codekorarjonno/18-DOF-Hexapod/raspberry_pi/ros2_ws/src/hexapod_description/meshes/README.md

# meshes

Generated by `tools/stl_to_urdf.py` from the SolidWorks STL export.
One file per link and colour, in metres, already in each link's frame.

Don't edit these by hand; re-export from SolidWorks and re-run the script.
