codekorarjonno/18-DOF-Hexapod/box.SLDPRT

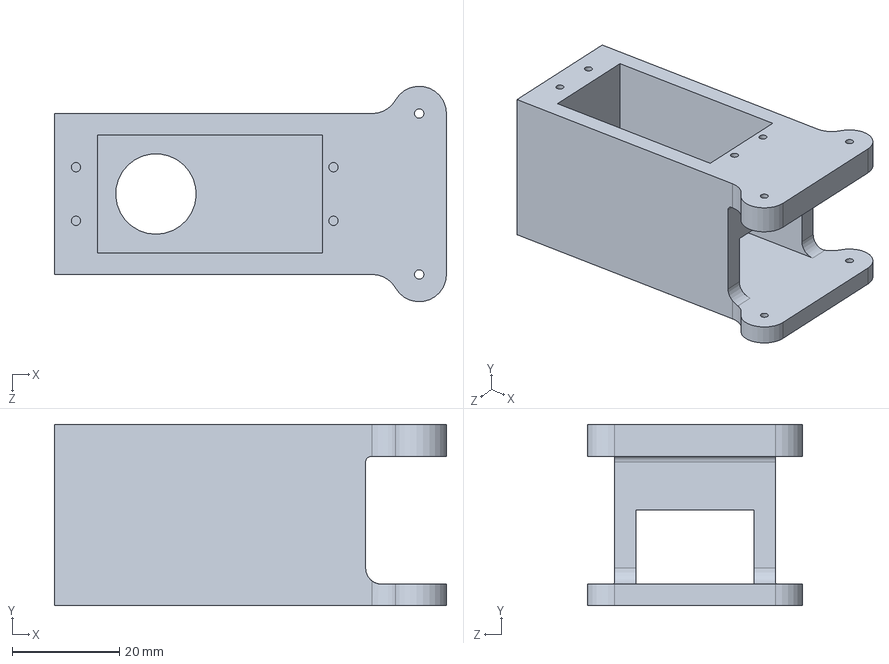
[picture p10: CAD file, 2026-10-17]
box.SLDPRT
73.1 x 33.8 x 40.1 mm
