codekorarjonno/18-DOF-Hexapod/raspberry_pi/ros2_ws/src/hexapod_description/meshes/base_frame.stl

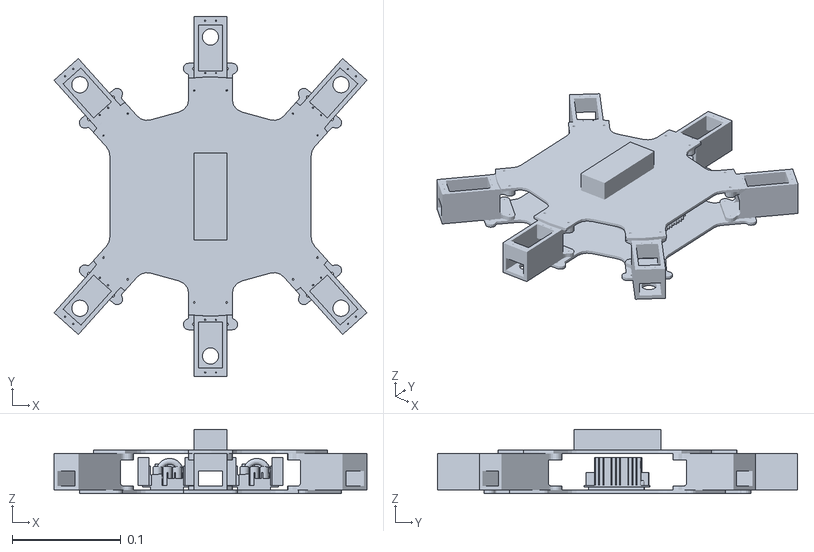
[picture p11: CAD file, 2026-11-06]
raspberry_pi/ros2_ws/src/hexapod_description/meshes/base_frame.stl
0.288 x 0.331 x 0.0588
