codekorarjonno/18-DOF-Hexapod/ros2_ws/src/hexapod_description/meshes/leg5_femur_servo.stl

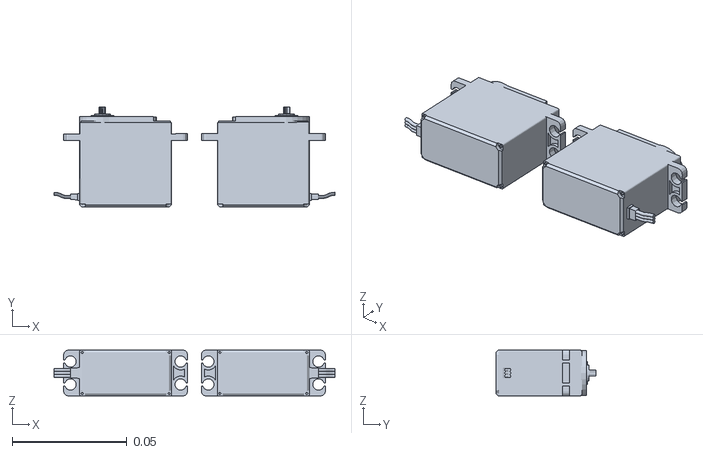
[picture p12: CAD file, 2026-11-02]
ros2_ws/src/hexapod_description/meshes/leg5_femur_servo.stl
0.122 x 0.0438 x 0.02
