codekorarjonno/18-DOF-Hexapod/solidworks/bracket.SLDPRT

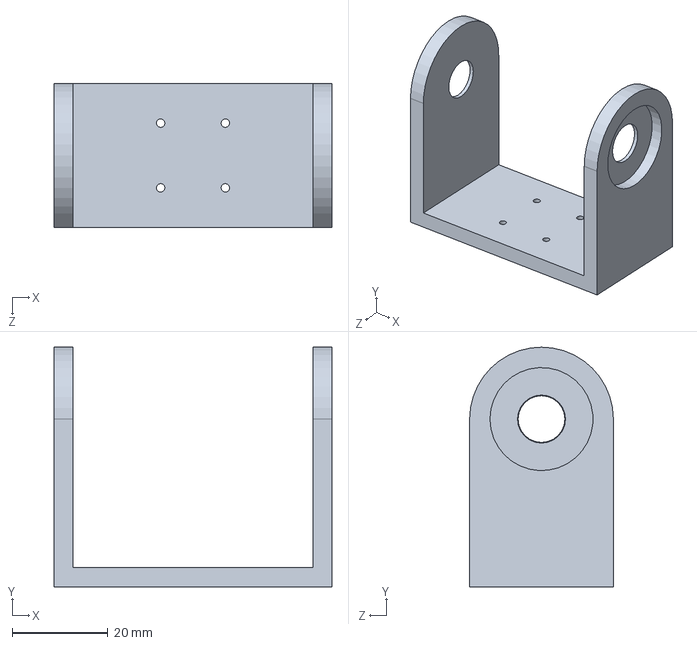
[picture p13: CAD file, 2026-11-02]
solidworks/bracket.SLDPRT
58.0 x 50.0 x 30.0 mm
