codekorarjonno/18-DOF-Hexapod/300W 20A DC-DC Buck Converter Step Down.step

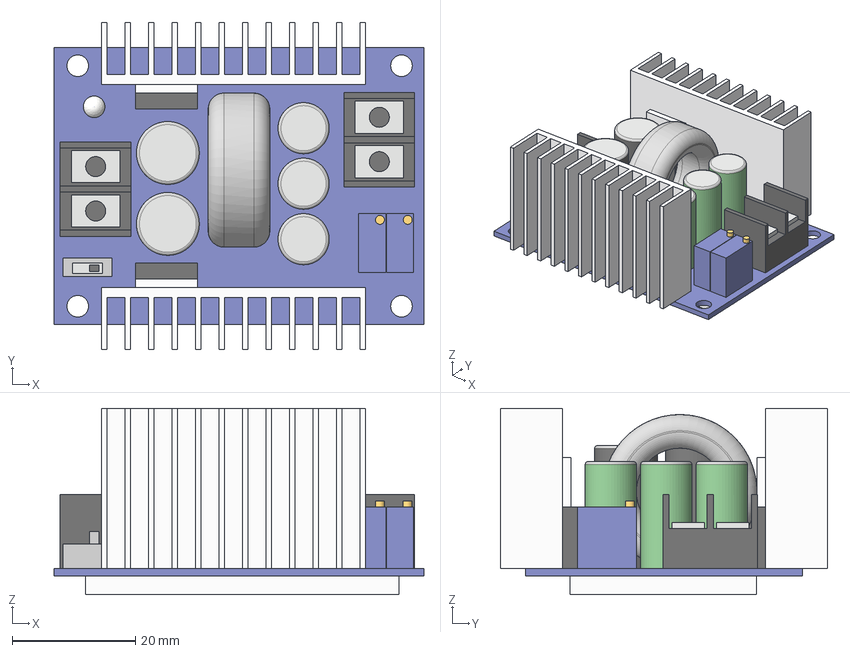
[picture p14: CAD file, 2026-10-17]
300W 20A DC-DC Buck Converter Step Down.step
60.0 x 53.0 x 30.2 mm
