codekorarjonno/18-DOF-Hexapod/raspberry_pi/ros2_ws/src/hexapod_description/meshes/leg0_tibia_horn.stl

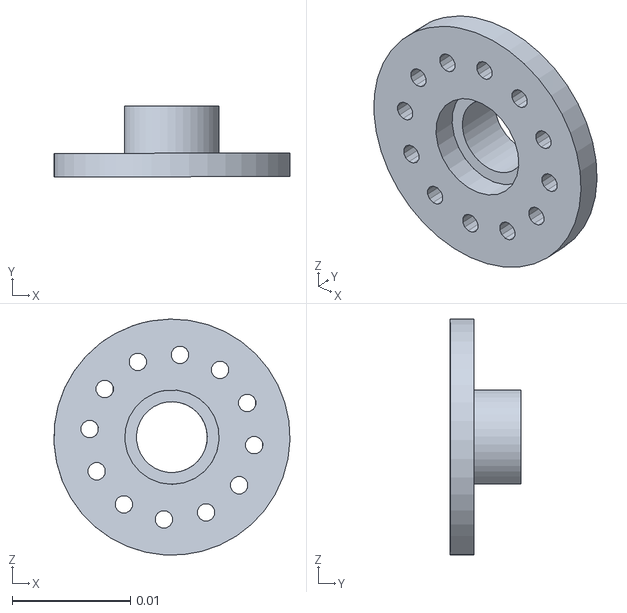
[picture p15: CAD file, 2026-11-06]
raspberry_pi/ros2_ws/src/hexapod_description/meshes/leg0_tibia_horn.stl
0.02 x 0.00604 x 0.02
