codekorarjonno/18-DOF-Hexapod/ros2_ws/src/hexapod_description/meshes/base_camera.stl

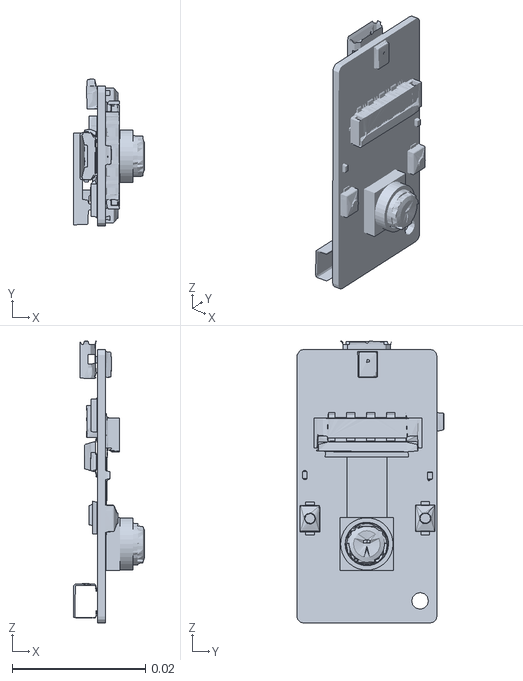
[picture p16: CAD file, 2026-11-02]
ros2_ws/src/hexapod_description/meshes/base_camera.stl
0.0107 x 0.0221 x 0.0423
