codekorarjonno/18-DOF-Hexapod/solidworks/ESP-EYE v2.step

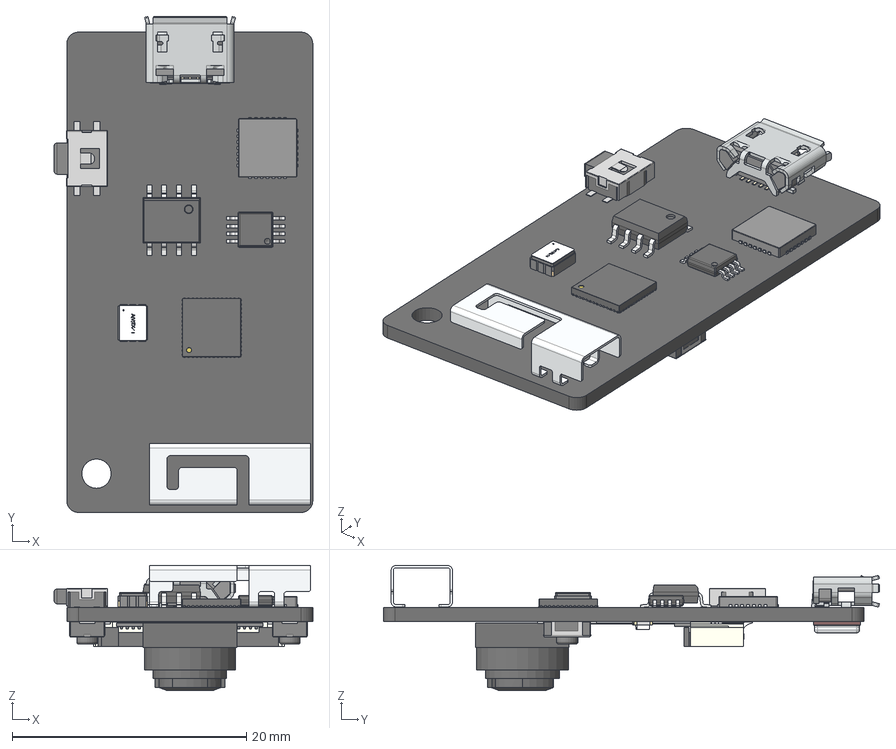
[picture p17: CAD file, 2026-11-02]
solidworks/ESP-EYE v2.step
22.1 x 42.3 x 10.7 mm
FPC-24
3x4x2mm - 2 Pad x 2
YD-3414 - Side SMD Switch
MSM261S4030_1
MSM261S4030_cover
OV2640
PRO-OB-440
ATX-11
shield
socket_housing
socket_plate
terminal x 5
SLP48-5x5
SOIC8-150-50
umax8 v0
