codekorarjonno/18-DOF-Hexapod/holder.SLDPRT

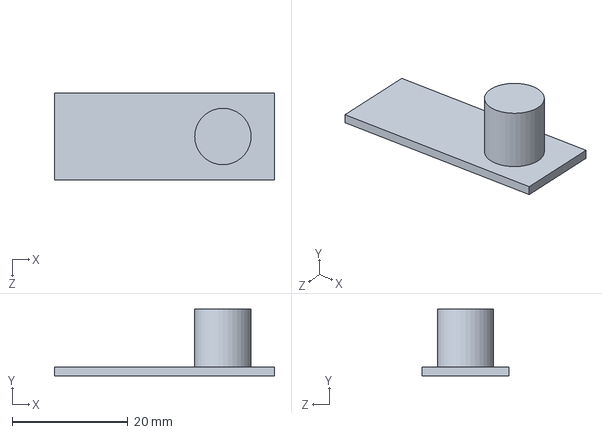
[picture p18: CAD file, 2026-10-17]
holder.SLDPRT
38.0 x 11.5 x 15.0 mm
