codekorarjonno/18-DOF-Hexapod/raspberry_pi/ros2_ws/src/hexapod_description/meshes/base_board.stl

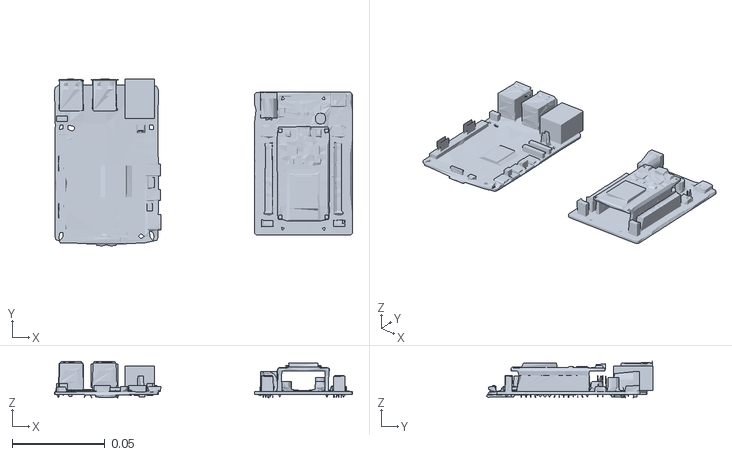
[picture p19: CAD file, 2026-11-06]
raspberry_pi/ros2_ws/src/hexapod_description/meshes/base_board.stl
0.16 x 0.0898 x 0.0196
