codekorarjonno/18-DOF-Hexapod/ros2_ws/src/hexapod_description/meshes/leg4_coxa_print.stl

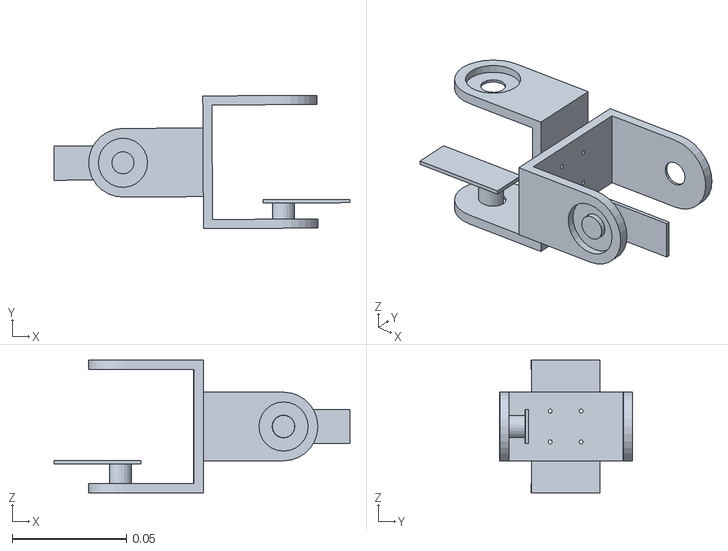
[picture p20: CAD file, 2026-11-02]
ros2_ws/src/hexapod_description/meshes/leg4_coxa_print.stl
0.129 x 0.0583 x 0.058
