codekorarjonno/18-DOF-Hexapod/solidworks/Perfect_MG996r.SLDPRT

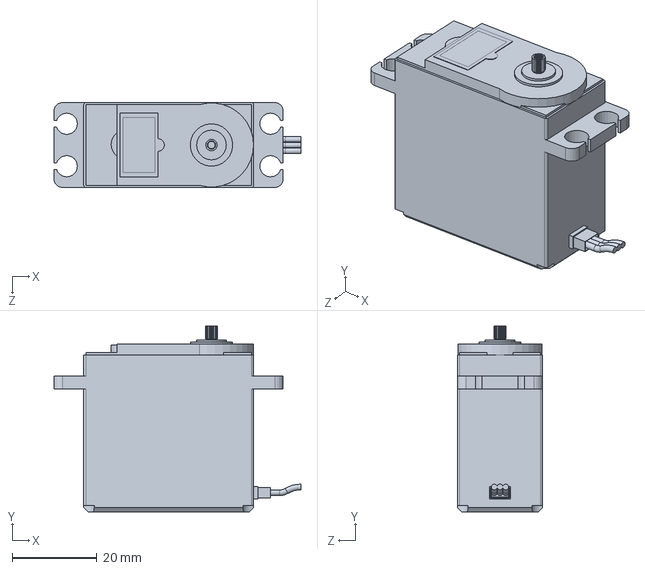
[picture p21: CAD file, 2026-11-02]
solidworks/Perfect_MG996r.SLDPRT
58.2 x 43.8 x 20.0 mm
