codekorarjonno/18-DOF-Hexapod/legpiece.SLDPRT

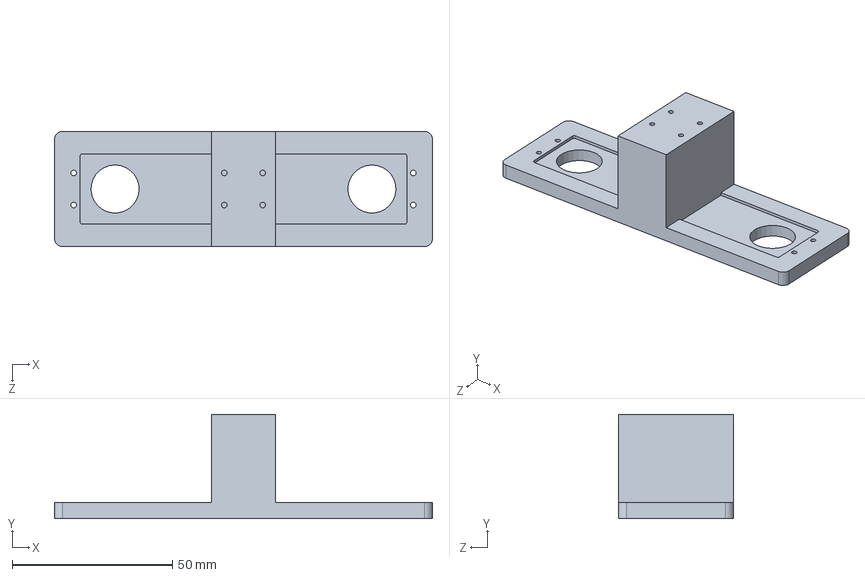
[picture p22: CAD file, 2026-10-17]
legpiece.SLDPRT
118.0 x 32.5 x 36.0 mm
