codekorarjonno/18-DOF-Hexapod/raspberry_pi/ros2_ws/src/hexapod_description/meshes/leg3_coxa_horn.stl

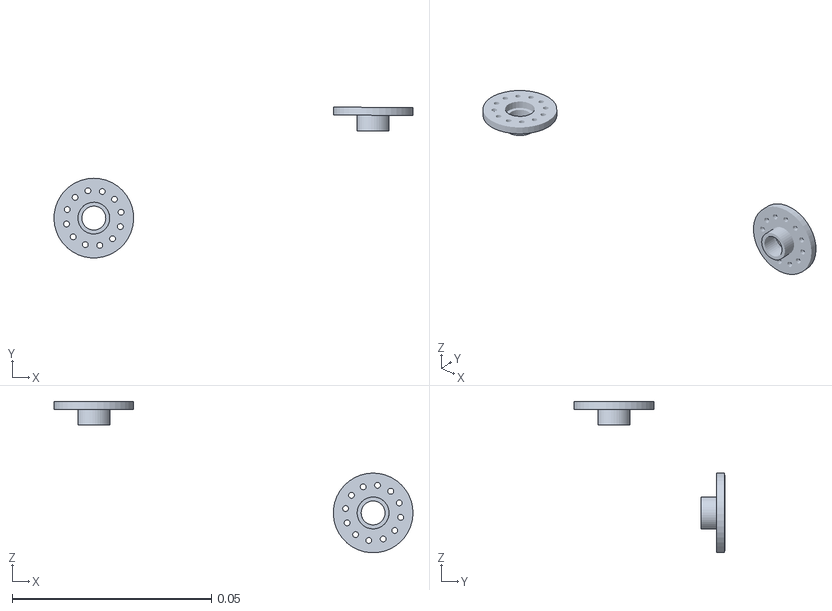
[picture p23: CAD file, 2026-11-06]
raspberry_pi/ros2_ws/src/hexapod_description/meshes/leg3_coxa_horn.stl
0.0901 x 0.0378 x 0.038
