codekorarjonno/18-DOF-Hexapod/ros2_ws/src/hexapod_description/meshes/leg4_tibia_horn.stl

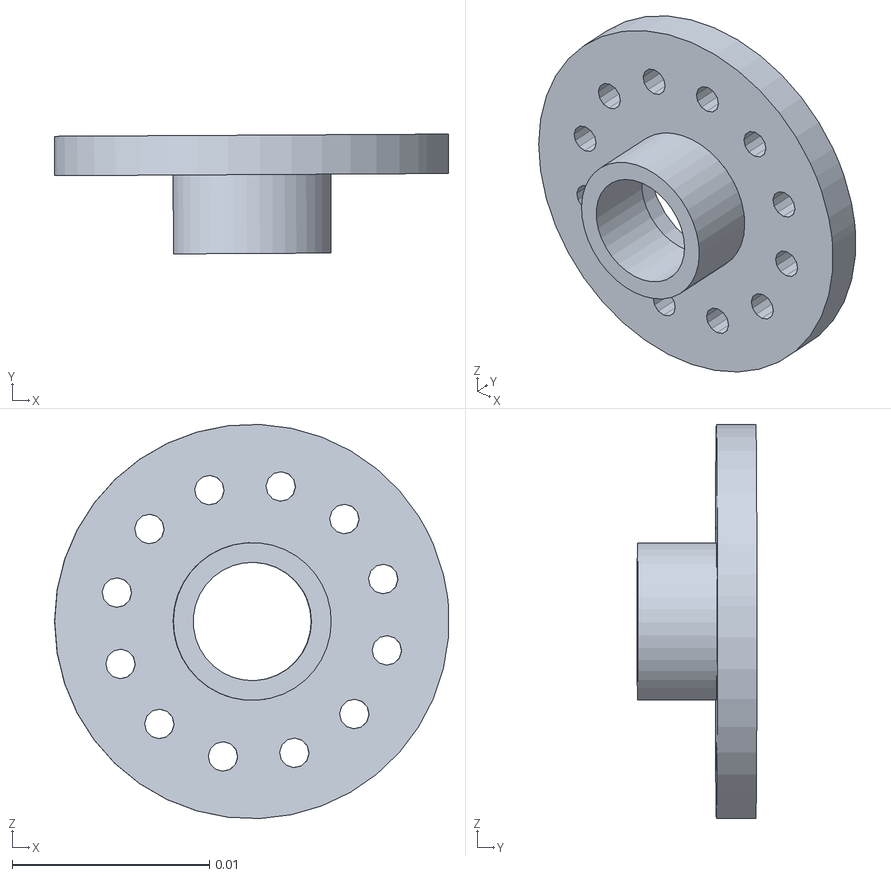
[picture p24: CAD file, 2026-11-02]
ros2_ws/src/hexapod_description/meshes/leg4_tibia_horn.stl
0.02 x 0.00608 x 0.02
