codekorarjonno/18-DOF-Hexapod/solidworks/long_leg.SLDPRT

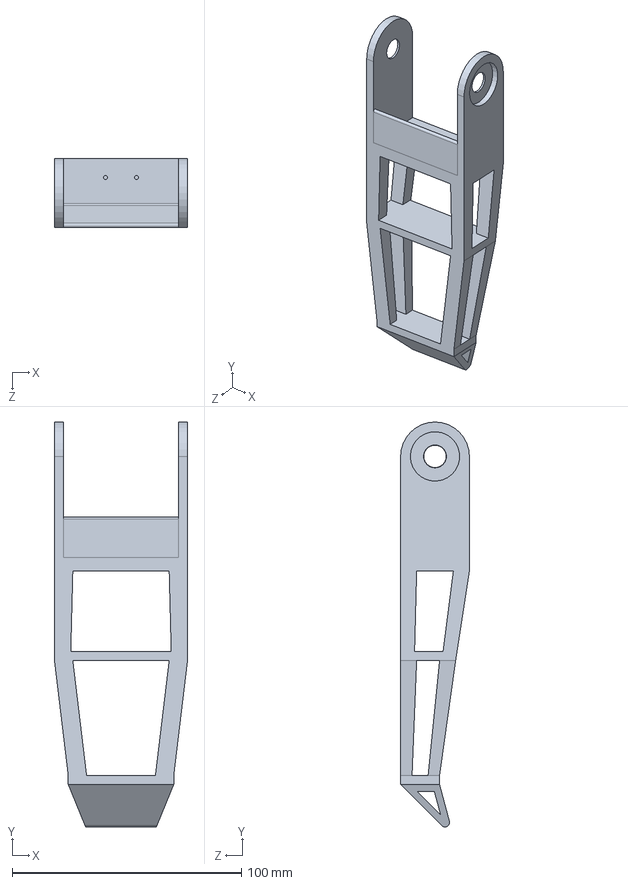
[picture p25: CAD file, 2026-11-02]
solidworks/long_leg.SLDPRT
58.0 x 176.5 x 30.0 mm
