codekorarjonno/18-DOF-Hexapod/ghost_spider_base.SLDPRT

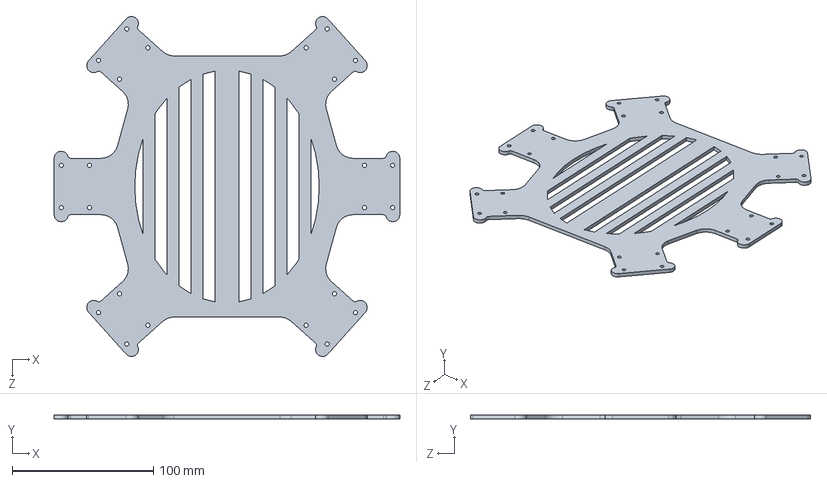
[picture p26: CAD file, 2026-10-17]
ghost_spider_base.SLDPRT
245.0 x 3.00 x 241.0 mm
