codekorarjonno/18-DOF-Hexapod/ros2_ws/src/hexapod_description/meshes/leg2_tibia_print.stl

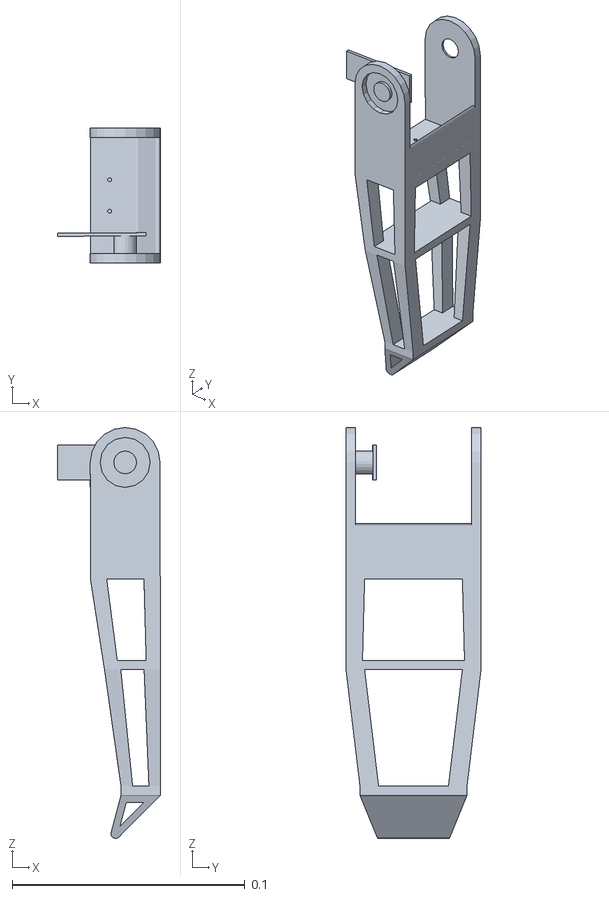
[picture p27: CAD file, 2026-11-02]
ros2_ws/src/hexapod_description/meshes/leg2_tibia_print.stl
0.0443 x 0.058 x 0.177
