codekorarjonno/18-DOF-Hexapod/solidworks/horn.SLDPRT

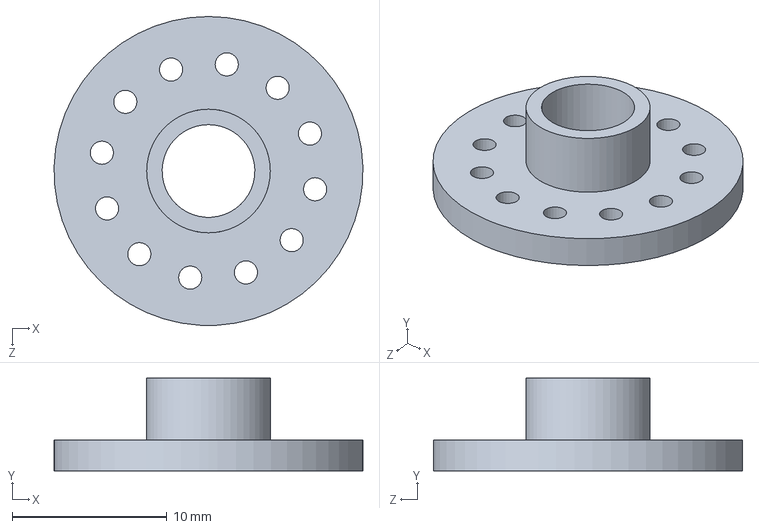
[picture p28: CAD file, 2026-11-02]
solidworks/horn.SLDPRT
20.0 x 6.00 x 20.0 mm
