codekorarjonno/18-DOF-Hexapod/solidworks/PCA9685 16.SLDPRT

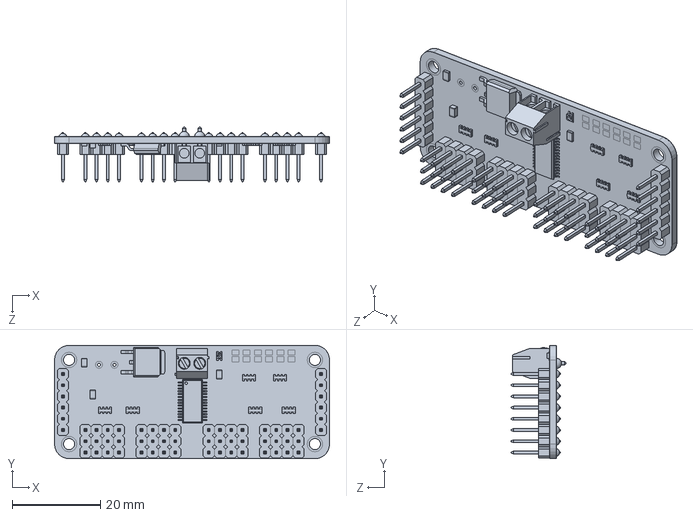
[picture p29: CAD file, 2026-11-02]
solidworks/PCA9685 16.SLDPRT
62.2 x 25.7 x 12.4 mm
