codekorarjonno/18-DOF-Hexapod/spider_base_cut.SLDPRT

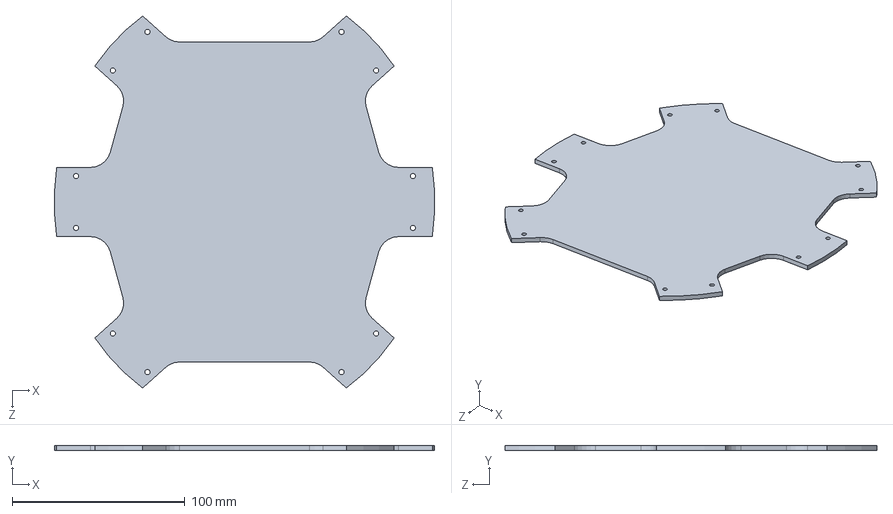
[picture p30: CAD file, 2026-10-17]
spider_base_cut.SLDPRT
219.7 x 3.00 x 215.1 mm
