codekorarjonno/18-DOF-Hexapod/ros2_ws/src/hexapod_description/meshes/leg0_tibia_print.stl

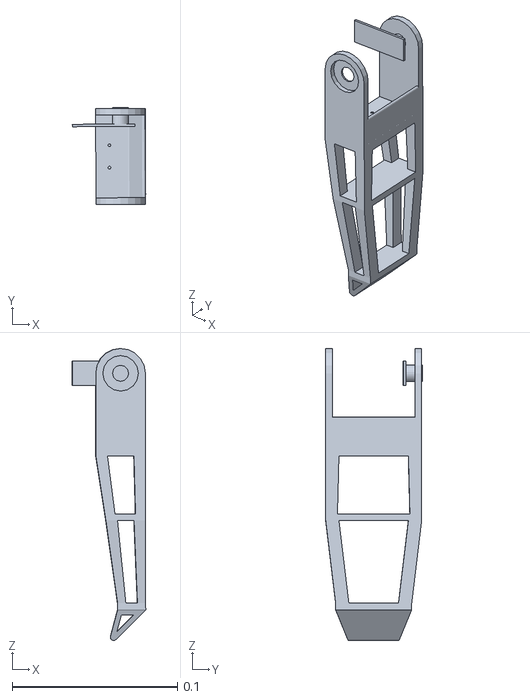
[picture p31: CAD file, 2026-11-02]
ros2_ws/src/hexapod_description/meshes/leg0_tibia_print.stl
0.0444 x 0.0586 x 0.177
