codekorarjonno/18-DOF-Hexapod/RPLIDAR C1.SLDPRT

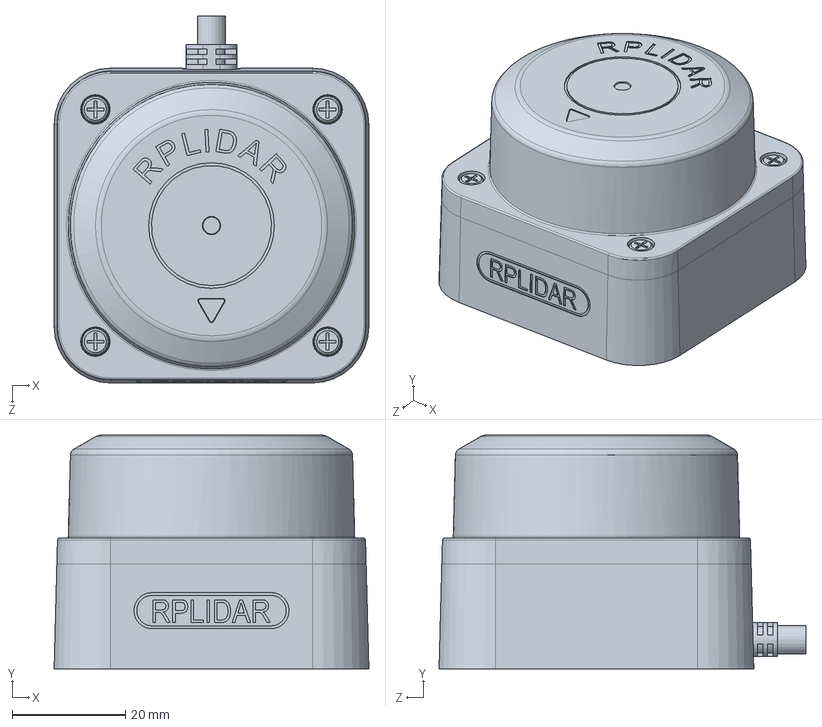
[picture p32: CAD file, 2026-10-17]
RPLIDAR C1.SLDPRT
55.6 x 41.3 x 64.8 mm
