codekorarjonno/18-DOF-Hexapod/ros2_ws/src/hexapod_description/meshes/leg0_coxa_print.stl

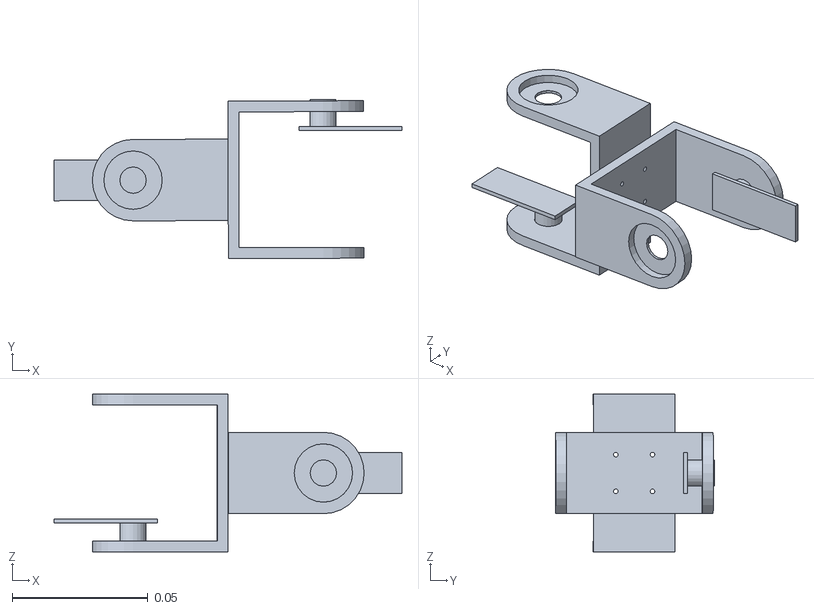
[picture p33: CAD file, 2026-11-02]
ros2_ws/src/hexapod_description/meshes/leg0_coxa_print.stl
0.128 x 0.0586 x 0.058
