codekorarjonno/18-DOF-Hexapod/solidworks/Raspberry-Pi-5.step

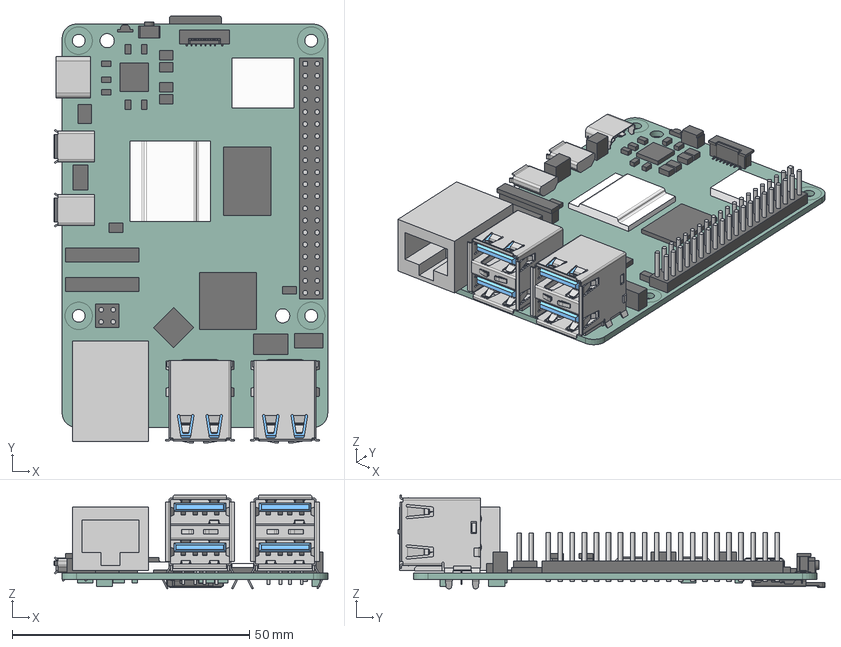
[picture p34: CAD file, 2026-11-02]
solidworks/Raspberry-Pi-5.step
57.7 x 90.0 x 19.8 mm
