codekorarjonno/18-DOF-Hexapod/raspberry_pi/ros2_ws/src/hexapod_description/meshes/leg3_femur_print.stl

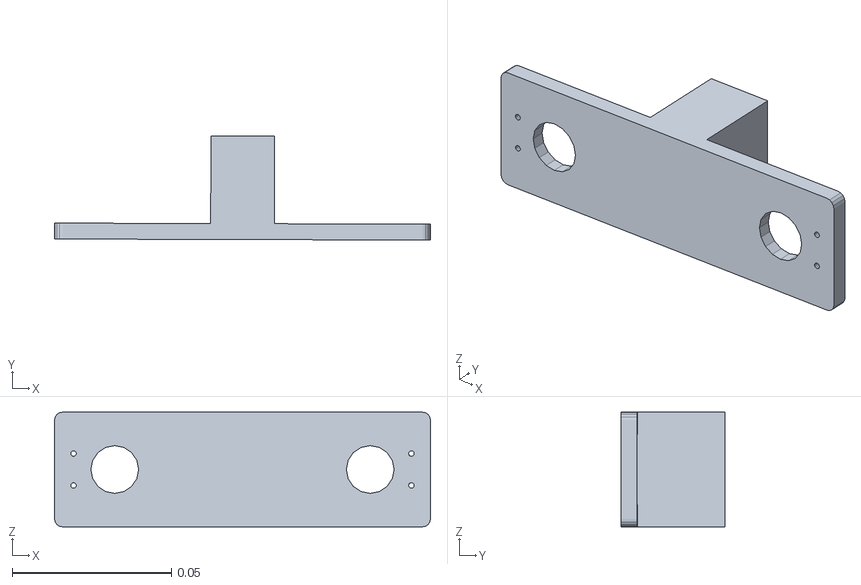
[picture p35: CAD file, 2026-11-06]
raspberry_pi/ros2_ws/src/hexapod_description/meshes/leg3_femur_print.stl
0.118 x 0.0327 x 0.036
