codekorarjonno/18-DOF-Hexapod/solidworks/trial.SLDPRT

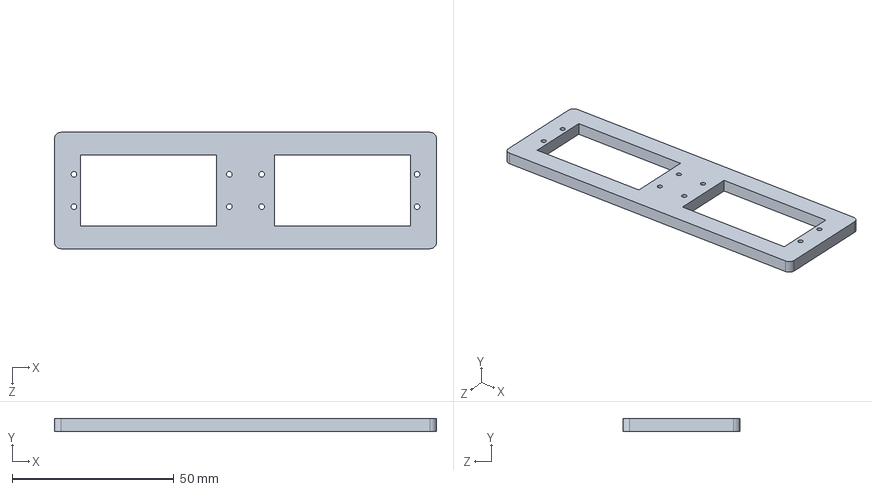
[picture p36: CAD file, 2026-11-02]
solidworks/trial.SLDPRT
118.0 x 4.00 x 36.0 mm
