codekorarjonno/18-DOF-Hexapod/solidworks/roof.SLDPRT

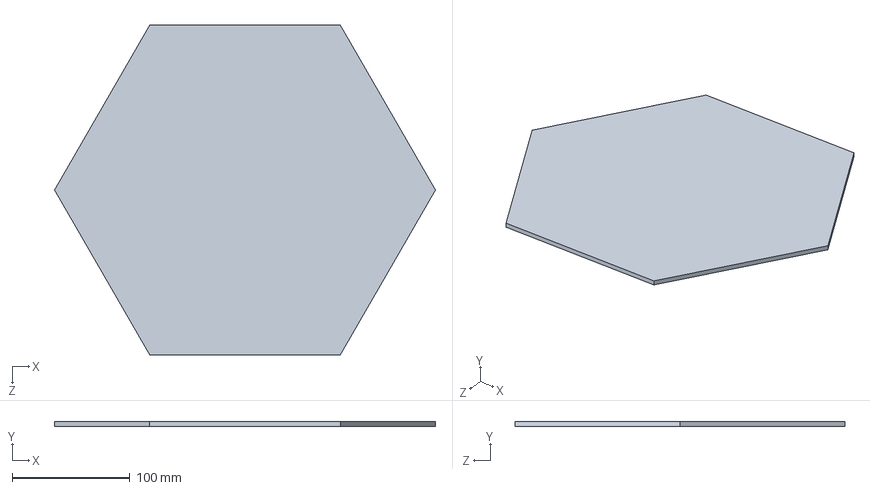
[picture p37: CAD file, 2026-11-02]
solidworks/roof.SLDPRT
323.3 x 4.00 x 280.0 mm
