codekorarjonno/18-DOF-Hexapod/ros2_ws/src/hexapod_description/meshes/base_lidar.stl

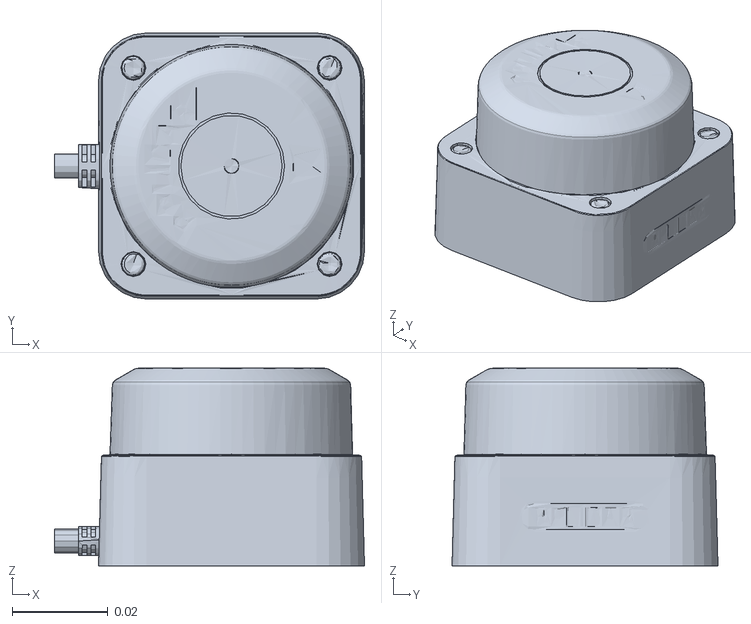
[picture p38: CAD file, 2026-11-02]
ros2_ws/src/hexapod_description/meshes/base_lidar.stl
0.0648 x 0.0556 x 0.0413
