codekorarjonno/18-DOF-Hexapod/raspberry_pi/ros2_ws/src/hexapod_description/meshes/base_servo.stl

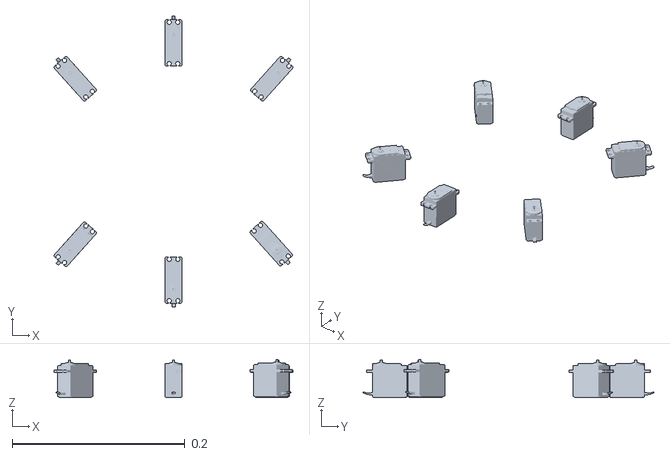
[picture p39: CAD file, 2026-11-06]
raspberry_pi/ros2_ws/src/hexapod_description/meshes/base_servo.stl
0.277 x 0.337 x 0.0445
