codekorarjonno/18-DOF-Hexapod/raspberry_pi/ros2_ws/src/hexapod_description/meshes/base_pca.stl

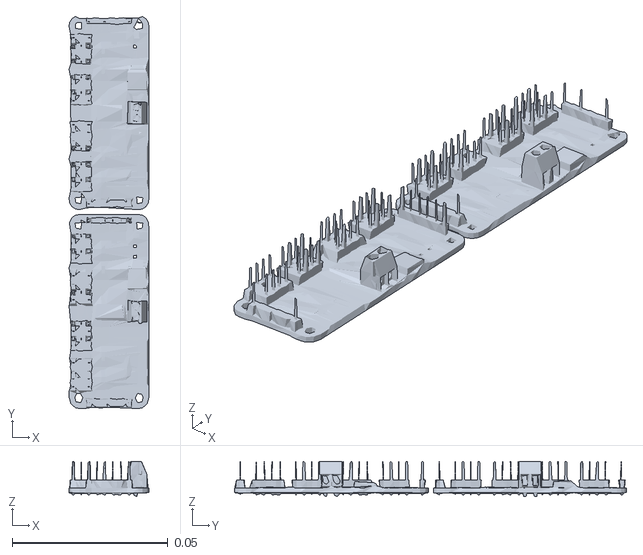
[picture p41: CAD file, 2026-11-06]
raspberry_pi/ros2_ws/src/hexapod_description/meshes/base_pca.stl
0.0257 x 0.126 x 0.0114
