codekorarjonno/18-DOF-Hexapod/solidworks/Hexapod_full_assembly.SLDASM

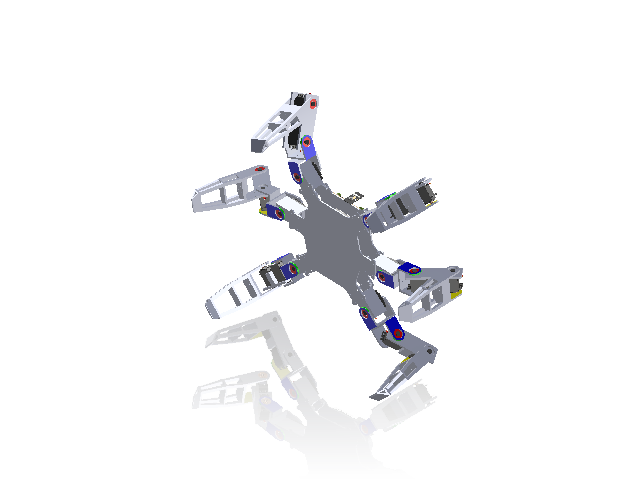
[picture p42: CAD file, 2026-11-02]
solidworks/Hexapod_full_assembly.SLDASM
Perfect_MG996r x 19
holder x 18
bracket x 12
horn x 18
trial
legpiece x 6
long_leg x 6
ghost_spider_base
d x 2
spider_base_cut
2025-12-06-21-34-39-655.step
2025-12-06-21-34-39-656.step
2025-12-06-21-34-39-657.step x 2
2025-12-06-21-34-39-658.step
2025-12-06-21-34-39-659.step
2025-12-06-21-34-39-660.step
2025-12-06-21-34-39-661.step x 2
2025-12-06-21-34-39-662.step
2025-12-06-21-34-39-663.step x 2
2025-12-06-21-34-39-664.step
2025-12-06-21-34-39-665.step
2025-12-06-21-34-39-666.step
2025-12-06-21-34-39-667.step
2025-12-06-21-34-39-668.step
2025-12-06-21-34-39-669.step
PCA9685 16 x 2
RPLIDAR C1
micro_usb_47346-0001.step
ESP-WROOM-32.step
6.ESP-32_Predeterminado.step
C_0805_2012Metric.step x 2
CP_Elec_6.3x5.4.step x 2
SOT-223_2.step x 2
PinSocket_2x15_P2.54mm_Vertical.step x 2
PinHeader_2x03_P2.54mm_Vertical.step x 2
CP_Elec_6.3x7.7.step
PinSocket_1x15_P2.54mm_Vertical.step x 2
PinSocket_2x03_P2.54mm_Vertical.step x 2
USB_C_Receptacle_GCT_USB4105-xx-A_16P_TopMnt_Horizontal.step
D_SMA.step
R_0805_2012Metric.step
LED_0805_2012Metric.step
BarrelJack_Horizontal.step
Shield ESP32_copper.step
Shield ESP32_silkscreen.step
Shield ESP32_soldermask.step
Shield ESP32_PCB.step
MSM261S4030_1.step
MSM261S4030_cover.step
Component1.step x 2
WL-SMCW SMT LED WURTH ELEKTRONIK 0603-0.step
WL-SMCW SMT LED WURTH ELEKTRONIK 0603-1.step
WL-SMCW SMT LED WURTH ELEKTRONIK 0603-2.step
WL-SMCW SMT LED WURTH ELEKTRONIK 0603-3.step
WL-SMCW SMT LED WURTH ELEKTRONIK 0603-4.step
WL-SMCW SMT LED WURTH ELEKTRONIK 0603-5.step
WL-SMCW SMT LED WURTH ELEKTRONIK 0603-6.step
WL-SMCW SMT LED WURTH ELEKTRONIK 0603_1-7.step
WL-SMCW SMT LED WURTH ELEKTRONIK 0603_1-8.step
WL-SMCW SMT LED WURTH ELEKTRONIK 0603_1-9.step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
