codekorarjonno/18-DOF-Hexapod/(list of files, cad)

Other CAD files:
raspberry_pi/ros2_ws/src/hexapod_description/meshes/leg5_coxa_horn.stl
raspberry_pi/ros2_ws/src/hexapod_description/meshes/leg4_tibia_print.stl
ros2_ws/src/hexapod_description/meshes/leg1_tibia_horn.stl
raspberry_pi/ros2_ws/src/hexapod_description/meshes/leg3_tibia_horn.stl
raspberry_pi/ros2_ws/src/hexapod_description/meshes/leg1_coxa_print.stl
ros2_ws/src/hexapod_description/meshes/leg4_coxa_horn.stl
raspberry_pi/ros2_ws/src/hexapod_description/meshes/leg5_coxa_print.stl
ros2_ws/src/hexapod_description/meshes/leg1_tibia_print.stl
solidworks/d.SLDPRT
raspberry_pi/ros2_ws/src/hexapod_description/meshes/leg0_femur_servo.stl
ros2_ws/src/hexapod_description/meshes/leg4_femur_servo.stl
raspberry_pi/ros2_ws/src/hexapod_description/meshes/leg2_femur_servo.stl
ros2_ws/src/hexapod_description/meshes/leg1_coxa_horn.stl
raspberry_pi/ros2_ws/src/hexapod_description/meshes/leg4_femur_print.stl
ros2_ws/src/hexapod_description/meshes/leg3_tibia_print.stl
raspberry_pi/ros2_ws/src/hexapod_description/meshes/leg5_tibia_print.stl
ros2_ws/src/hexapod_description/meshes/leg0_coxa_horn.stl
raspberry_pi/ros2_ws/src/hexapod_description/meshes/leg3_femur_servo.stl
raspberry_pi/ros2_ws/src/hexapod_description/meshes/leg1_femur_print.stl
ros2_ws/src/hexapod_description/meshes/leg5_tibia_horn.stl
raspberry_pi/ros2_ws/src/hexapod_description/meshes/leg1_femur_servo.stl
ros2_ws/src/hexapod_description/meshes/leg2_coxa_horn.stl
ros2_ws/src/hexapod_description/meshes/leg3_coxa_print.stl
ros2_ws/src/hexapod_description/meshes/leg2_coxa_print.stl
raspberry_pi/ros2_ws/src/hexapod_description/meshes/leg5_femur_print.stl
raspberry_pi/ros2_ws/src/hexapod_description/meshes/leg2_tibia_horn.stl
raspberry_pi/ros2_ws/src/hexapod_description/meshes/leg2_femur_print.stl
