codekorarjonno/18-DOF-Hexapod/ros2_ws/src/hexapod_description/urdf/hexapod.urdf.xacro

<?xml version="1.0"?>
<!--
  hexapod.urdf.xacro  -  GENERATED by tools/stl_to_urdf.py from the SolidWorks
  assembly (Hexapod_full_assembly). Re-run that script after changing the CAD
  instead of editing the numbers here.

  Leg numbers and joint signs match hexapod_gripper.ino:

              front (+x)
          0 =========== 3
          |             |
          1    base     4        +y is LEFT
          |             |
          2 =========== 5
              back

  joint = (firmware logical angle - 90 deg) in radians; 0 everywhere = stance (h)
    coxa  +  leg swings toward the front
    femur +  foot lifts up
    tibia +  foot curls in toward the body
  gripper_joint: 0 = open (150 deg), upper limit = closed (100 deg)

  Not in the CAD, so placed by hand:  gripper, imu_link, battery mass.
-->
<robot name="hexapod" xmlns:xacro="http://www.ros.org/wiki/xacro">

  <xacro:arg name="use_meshes" default="true"/>
  <xacro:property name="use_meshes" value="$(arg use_meshes)"/>

  <!-- lidar mounting turn in radians (3.14159 if the scan shows up backwards) -->
  <xacro:arg name="laser_yaw" default="0.0"/>

  <!-- firmware clamps every joint to 25..155 deg = +-65 deg from neutral -->
  <xacro:property name="joint_limit" value="${radians(65)}"/>
  <!-- servo torque limit, N m (MG996R ~1.1 at 6 V); Gazebo can raise it -->
  <xacro:arg name="servo_effort" default="1.2"/>
  <xacro:property name="servo_effort" value="$(arg servo_effort)"/>
  <xacro:property name="servo_speed" value="5.0"/>   <!-- rad/s -->

  <material name="print"><color rgba="0.95 0.50 0.10 1"/></material>
  <material name="frame"><color rgba="0.30 0.30 0.32 1"/></material>
  <material name="servo"><color rgba="0.08 0.08 0.08 1"/></material>
  <material name="horn"><color rgba="0.92 0.92 0.92 1"/></material>
  <material name="lidar"><color rgba="0.10 0.10 0.12 1"/></material>
  <material name="board"><color rgba="0.10 0.45 0.25 1"/></material>
  <material name="pca"><color rgba="0.20 0.30 0.70 1"/></material>
  <material name="camera"><color rgba="0.05 0.05 0.05 1"/></material>

  <!-- ============================== BODY ============================== -->

  <link name="base_footprint"/>
  <joint name="base_joint" type="fixed">
    <parent link="base_footprint"/><child link="base_link"/>
    <origin xyz="0 0 0.1615"/>
  </joint>
  <link name="base_link">
    <xacro:if value="${use_meshes}">
      <visual><geometry><mesh filename="package://hexapod_description/meshes/base_camera.stl"/></geometry><material name="camera"/></visual>
      <visual><geometry><mesh filename="package://hexapod_description/meshes/base_pca.stl"/></geometry><material name="pca"/></visual>
      <visual><geometry><mesh filename="package://hexapod_description/meshes/base_servo.stl"/></geometry><material name="servo"/></visual>
      <visual><geometry><mesh filename="package://hexapod_description/meshes/base_lidar.stl"/></geometry><material name="lidar"/></visual>
      <visual><geometry><mesh filename="package://hexapod_description/meshes/base_board.stl"/></geometry><material name="board"/></visual>
      <visual><geometry><mesh filename="package://hexapod_description/meshes/base_frame.stl"/></geometry><material name="frame"/></visual>
    </xacro:if>
    <xacro:unless value="${use_meshes}">
      <visual><origin xyz="0.00012 -0.00012 0.00575"/><geometry><box size="0.28753 0.33717 0.0588"/></geometry><material name="frame"/></visual>
    </xacro:unless>
    <collision><origin xyz="0.00012 -0.00012 0.00575"/><geometry><box size="0.28753 0.33717 0.0588"/></geometry></collision>
    <inertial><origin xyz="0.00005 0.0001 0.01293"/><mass value="0.8149"/><inertia ixx="6.570e-03" ixy="-1.467e-05" ixz="8.063e-06" iyy="5.314e-03" iyz="1.999e-06" izz="1.100e-02"/></inertial>
  </link>

  <!-- ============================== LEG 0 ============================== -->

  <joint name="leg0_coxa_joint" type="revolute">
    <parent link="base_link"/><child link="leg0_coxa_link"/>
    <origin xyz="0.12041 -0.10305 0" rpy="0 0 -0.84291"/>
    <axis xyz="0 0 1"/>
    <limit lower="${-joint_limit}" upper="${joint_limit}" effort="${servo_effort}" velocity="${servo_speed}"/>
  </joint>
  <link name="leg0_coxa_link">
    <xacro:if value="${use_meshes}">
      <visual><geometry><mesh filename="package://hexapod_description/meshes/leg0_coxa_print.stl"/></geometry><material name="print"/></visual>
      <visual><geometry><mesh filename="package://hexapod_description/meshes/leg0_coxa_horn.stl"/></geometry><material name="horn"/></visual>
    </xacro:if>
    <xacro:unless value="${use_meshes}">
      <visual><origin xyz="0.03454 0.00037 0.00185"/><geometry><box size="0.12815 0.05863 0.058"/></geometry><material name="print"/></visual>
    </xacro:unless>
    <collision><origin xyz="0.03454 0.00037 0.00185"/><geometry><box size="0.12815 0.05863 0.058"/></geometry></collision>
    <inertial><origin xyz="0.0346 -0.00098 0.00296"/><mass value="0.0266"/><inertia ixx="1.210e-05" ixy="4.194e-07" ixz="5.729e-07" iyy="3.599e-05" iyz="-2.742e-08" izz="3.611e-05"/></inertial>
  </link>
  <joint name="leg0_femur_joint" type="revolute">
    <parent link="leg0_coxa_link"/><child link="leg0_femur_link"/>
    <origin xyz="0.06995 0 -0.0002" rpy="0 0 0"/>
    <axis xyz="0 -1 0"/>
    <limit lower="${-joint_limit}" upper="${joint_limit}" effort="${servo_effort}" velocity="${servo_speed}"/>
  </joint>
  <link name="leg0_femur_link">
    <xacro:if value="${use_meshes}">
      <visual><geometry><mesh filename="package://hexapod_description/meshes/leg0_femur_servo.stl"/></geometry><material name="servo"/></visual>
      <visual><geometry><mesh filename="package://hexapod_description/meshes/leg0_femur_print.stl"/></geometry><material name="print"/></visual>
    </xacro:if>
    <xacro:unless value="${use_meshes}">
      <visual><origin xyz="0.03968 0.00019 0.00204"/><geometry><box size="0.12236 0.04757 0.036"/></geometry><material name="print"/></visual>
    </xacro:unless>
    <collision><origin xyz="0.03968 0.00019 0.00204"/><geometry><box size="0.12236 0.04757 0.036"/></geometry></collision>
    <inertial><origin xyz="0.03971 -0.0009 0.00204"/><mass value="0.1363"/><inertia ixx="2.976e-05" ixy="-3.715e-07" ixz="-5.864e-13" iyy="1.814e-04" iyz="3.415e-14" izz="1.981e-04"/></inertial>
  </link>
  <joint name="leg0_tibia_joint" type="revolute">
    <parent link="leg0_femur_link"/><child link="leg0_tibia_link"/>
    <origin xyz="0.08012 0 -0.00009" rpy="0 0 0"/>
    <axis xyz="0 1 0"/>
    <limit lower="${-joint_limit}" upper="${joint_limit}" effort="${servo_effort}" velocity="${servo_speed}"/>
  </joint>
  <link name="leg0_tibia_link">
    <xacro:if value="${use_meshes}">
      <visual><geometry><mesh filename="package://hexapod_description/meshes/leg0_tibia_print.stl"/></geometry><material name="print"/></visual>
      <visual><geometry><mesh filename="package://hexapod_description/meshes/leg0_tibia_horn.stl"/></geometry><material name="horn"/></visual>
    </xacro:if>
    <xacro:unless value="${use_meshes}">
      <visual><origin xyz="-0.00724 0.00065 -0.07113"/><geometry><box size="0.04444 0.05856 0.17653"/></geometry><material name="print"/></visual>
    </xacro:unless>
    <collision><origin xyz="-0.00724 0.00065 -0.06113"/><geometry><box size="0.04444 0.05856 0.15653"/></geometry></collision>
    <collision name="leg0_foot_collision"><origin xyz="-0.00419 0.00494 -0.15323"/><geometry><sphere radius="0.008"/></geometry></collision>
    <inertial><origin xyz="-0.00076 -0.00032 -0.06129"/><mass value="0.0372"/><inertia ixx="1.191e-04" ixy="5.006e-07" ixz="1.301e-06" iyy="1.101e-04" iyz="1.752e-06" izz="1.509e-05"/></inertial>
  </link>
  <link name="leg0_foot"/>
  <joint name="leg0_foot_joint" type="fixed">
    <parent link="leg0_tibia_link"/><child link="leg0_foot"/>
    <origin xyz="-0.00419 0.00494 -0.16123"/>
  </joint>

  <!-- ============================== LEG 1 ============================== -->

  <joint name="leg1_coxa_joint" type="revolute">
    <parent link="base_link"/><child link="leg1_coxa_link"/>
    <origin xyz="0.00011 -0.14751 0" rpy="0 0 -1.56533"/>
    <axis xyz="0 0 1"/>
    <limit lower="${-joint_limit}" upper="${joint_limit}" effort="${servo_effort}" velocity="${servo_speed}"/>
  </joint>
  <link name="leg1_coxa_link">
    <xacro:if value="${use_meshes}">
      <visual><geometry><mesh filename="package://hexapod_description/meshes/leg1_coxa_print.stl"/></geometry><material name="print"/></visual>
      <visual><geometry><mesh filename="package://hexapod_description/meshes/leg1_coxa_horn.stl"/></geometry><material name="horn"/></visual>
    </xacro:if>
    <xacro:unless value="${use_meshes}">
      <visual><origin xyz="0.03462 -0.00029 -0.00035"/><geometry><box size="0.12931 0.05826 0.058"/></geometry><material name="print"/></visual>
    </xacro:unless>
    <collision><origin xyz="0.03462 -0.00029 -0.00035"/><geometry><box size="0.12931 0.05826 0.058"/></geometry></collision>
    <inertial><origin xyz="0.03503 -0.00143 0.00092"/><mass value="0.0266"/><inertia ixx="1.164e-05" ixy="8.743e-07" ixz="7.258e-07" iyy="3.596e-05" iyz="-4.580e-08" izz="3.601e-05"/></inertial>
  </link>
  <joint name="leg1_femur_joint" type="revolute">
    <parent link="leg1_coxa_link"/><child link="leg1_femur_link"/>
    <origin xyz="0.06995 0 -0.0002" rpy="0 0 0"/>
    <axis xyz="0 -1 0"/>
    <limit lower="${-joint_limit}" upper="${joint_limit}" effort="${servo_effort}" velocity="${servo_speed}"/>
  </joint>
  <link name="leg1_femur_link">
    <xacro:if value="${use_meshes}">
      <visual><geometry><mesh filename="package://hexapod_description/meshes/leg1_femur_servo.stl"/></geometry><material name="servo"/></visual>
      <visual><geometry><mesh filename="package://hexapod_description/meshes/leg1_femur_print.stl"/></geometry><material name="print"/></visual>
    </xacro:if>
    <xacro:unless value="${use_meshes}">
      <visual><origin xyz="0.04029 -0.00363 -0.00016"/><geometry><box size="0.12237 0.04778 0.036"/></geometry><material name="print"/></visual>
    </xacro:unless>
    <collision><origin xyz="0.04029 -0.00363 -0.00016"/><geometry><box size="0.12237 0.04778 0.036"/></geometry></collision>
    <inertial><origin xyz="0.04025 -0.0039 -0.00016"/><mass value="0.1310"/><inertia ixx="2.696e-05" ixy="6.408e-07" ixz="-6.588e-13" iyy="1.747e-04" iyz="-8.964e-14" izz="1.897e-04"/></inertial>
  </link>
  <joint name="leg1_tibia_joint" type="revolute">
    <parent link="leg1_femur_link"/><child link="leg1_tibia_link"/>
    <origin xyz="0.08012 0 -0.00009" rpy="0 0 0"/>
    <axis xyz="0 1 0"/>
    <limit lower="${-joint_limit}" upper="${joint_limit}" effort="${servo_effort}" velocity="${servo_speed}"/>
  </joint>
  <link name="leg1_tibia_link">
    <xacro:if value="${use_meshes}">
      <visual><geometry><mesh filename="package://hexapod_description/meshes/leg1_tibia_print.stl"/></geometry><material name="print"/></visual>
      <visual><geometry><mesh filename="package://hexapod_description/meshes/leg1_tibia_horn.stl"/></geometry><material name="horn"/></visual>
    </xacro:if>
    <xacro:unless value="${use_meshes}">
      <visual><origin xyz="-0.00663 -0.00177 -0.07333"/><geometry><box size="0.04434 0.05816 0.17653"/></geometry><material name="print"/></visual>
    </xacro:unless>
    <collision><origin xyz="-0.00663 -0.00177 -0.06333"/><geometry><box size="0.04434 0.05816 0.15653"/></geometry></collision>
    <collision name="leg1_foot_collision"><origin xyz="-0.00419 0.00494 -0.15323"/><geometry><sphere radius="0.008"/></geometry></collision>
    <inertial><origin xyz="-0.00027 -0.00261 -0.06349"/><mass value="0.0372"/><inertia ixx="1.190e-04" ixy="4.386e-07" ixz="1.326e-06" iyy="1.101e-04" iyz="2.001e-06" izz="1.494e-05"/></inertial>
  </link>
  <link name="leg1_foot"/>
  <joint name="leg1_foot_joint" type="fixed">
    <parent link="leg1_tibia_link"/><child link="leg1_foot"/>
    <origin xyz="-0.00419 0.00494 -0.16123"/>
  </joint>

  <!-- ============================== LEG 2 ============================== -->

  <joint name="leg2_coxa_joint" type="revolute">
    <parent link="base_link"/><child link="leg2_coxa_link"/>
    <origin xyz="-0.12052 -0.10344 0" rpy="0 0 -2.30169"/>
    <axis xyz="0 0 1"/>
    <limit lower="${-joint_limit}" upper="${joint_limit}" effort="${servo_effort}" velocity="${servo_speed}"/>
  </joint>
  <link name="leg2_coxa_link">
    <xacro:if value="${use_meshes}">
      <visual><geometry><mesh filename="package://hexapod_description/meshes/leg2_coxa_print.stl"/></geometry><material name="print"/></visual>
      <visual><geometry><mesh filename="package://hexapod_description/meshes/leg2_coxa_horn.stl"/></geometry><material name="horn"/></visual>
    </xacro:if>
    <xacro:unless value="${use_meshes}">
      <visual><origin xyz="0.03457 0.00011 -0.00035"/><geometry><box size="0.12919 0.05801 0.058"/></geometry><material name="print"/></visual>
    </xacro:unless>
    <collision><origin xyz="0.03457 0.00011 -0.00035"/><geometry><box size="0.12919 0.05801 0.058"/></geometry></collision>
    <inertial><origin xyz="0.03499 0.0013 0.00092"/><mass value="0.0266"/><inertia ixx="1.169e-05" ixy="-6.670e-07" ixz="7.283e-07" iyy="3.596e-05" iyz="3.954e-08" izz="3.607e-05"/></inertial>
  </link>
  <joint name="leg2_femur_joint" type="revolute">
    <parent link="leg2_coxa_link"/><child link="leg2_femur_link"/>
    <origin xyz="0.06995 0 -0.0002" rpy="0 0 0"/>
    <axis xyz="0 -1 0"/>
    <limit lower="${-joint_limit}" upper="${joint_limit}" effort="${servo_effort}" velocity="${servo_speed}"/>
  </joint>
  <link name="leg2_femur_link">
    <xacro:if value="${use_meshes}">
      <visual><geometry><mesh filename="package://hexapod_description/meshes/leg2_femur_servo.stl"/></geometry><material name="servo"/></visual>
      <visual><geometry><mesh filename="package://hexapod_description/meshes/leg2_femur_print.stl"/></geometry><material name="print"/></visual>
    </xacro:if>
    <xacro:unless value="${use_meshes}">
      <visual><origin xyz="0.04021 0.00224 -0.00016"/><geometry><box size="0.12236 0.04726 0.036"/></geometry><material name="print"/></visual>
    </xacro:unless>
    <collision><origin xyz="0.04021 0.00224 -0.00016"/><geometry><box size="0.12236 0.04726 0.036"/></geometry></collision>
    <inertial><origin xyz="0.04021 0.00253 -0.00016"/><mass value="0.1310"/><inertia ixx="2.681e-05" ixy="-1.767e-08" ixz="1.607e-13" iyy="1.747e-04" iyz="-1.130e-13" izz="1.896e-04"/></inertial>
  </link>
  <joint name="leg2_tibia_joint" type="revolute">
    <parent link="leg2_femur_link"/><child link="leg2_tibia_link"/>
    <origin xyz="0.08012 0 -0.00009" rpy="0 0 0"/>
    <axis xyz="0 1 0"/>
    <limit lower="${-joint_limit}" upper="${joint_limit}" effort="${servo_effort}" velocity="${servo_speed}"/>
  </joint>
  <link name="leg2_tibia_link">
    <xacro:if value="${use_meshes}">
      <visual><geometry><mesh filename="package://hexapod_description/meshes/leg2_tibia_print.stl"/></geometry><material name="print"/></visual>
      <visual><geometry><mesh filename="package://hexapod_description/meshes/leg2_tibia_horn.stl"/></geometry><material name="horn"/></visual>
    </xacro:if>
    <xacro:unless value="${use_meshes}">
      <visual><origin xyz="-0.00676 0.00013 -0.07333"/><geometry><box size="0.04431 0.058 0.17653"/></geometry><material name="print"/></visual>
    </xacro:unless>
    <collision><origin xyz="-0.00676 0.00013 -0.06333"/><geometry><box size="0.04431 0.058 0.15653"/></geometry></collision>
    <collision name="leg2_foot_collision"><origin xyz="-0.00419 0.00494 -0.15323"/><geometry><sphere radius="0.008"/></geometry></collision>
    <inertial><origin xyz="-0.00027 0.00097 -0.06349"/><mass value="0.0372"/><inertia ixx="1.189e-04" ixy="-4.515e-07" ixz="1.317e-06" iyy="1.100e-04" iyz="-1.998e-06" izz="1.485e-05"/></inertial>
  </link>
  <link name="leg2_foot"/>
  <joint name="leg2_foot_joint" type="fixed">
    <parent link="leg2_tibia_link"/><child link="leg2_foot"/>
    <origin xyz="-0.00419 0.00494 -0.16123"/>
  </joint>

  <!-- ============================== LEG 3 ============================== -->

  <joint name="leg3_coxa_joint" type="revolute">
    <parent link="base_link"/><child link="leg3_coxa_link"/>
    <origin xyz="0.12041 0.10305 0" rpy="0 0 0.84291"/>
    <axis xyz="0 0 -1"/>
    <limit lower="${-joint_limit}" upper="${joint_limit}" effort="${servo_effort}" velocity="${servo_speed}"/>
  </joint>
  <link name="leg3_coxa_link">
    <xacro:if value="${use_meshes}">
      <visual><geometry><mesh filename="package://hexapod_description/meshes/leg3_coxa_print.stl"/></geometry><material name="print"/></visual>
      <visual><geometry><mesh filename="package://hexapod_description/meshes/leg3_coxa_horn.stl"/></geometry><material name="horn"/></visual>
    </xacro:if>
    <xacro:unless value="${use_meshes}">
      <visual><origin xyz="0.03488 -0.00023 -0.00035"/><geometry><box size="0.12916 0.05814 0.058"/></geometry><material name="print"/></visual>
    </xacro:unless>
    <collision><origin xyz="0.03488 -0.00023 -0.00035"/><geometry><box size="0.12916 0.05814 0.058"/></geometry></collision>
    <inertial><origin xyz="0.03536 0.00099 0.00087"/><mass value="0.0266"/><inertia ixx="1.181e-05" ixy="-5.611e-07" ixz="6.627e-07" iyy="3.604e-05" iyz="3.341e-08" izz="3.614e-05"/></inertial>
  </link>
  <joint name="leg3_femur_joint" type="revolute">
    <parent link="leg3_coxa_link"/><child link="leg3_femur_link"/>
    <origin xyz="0.06995 0 -0.0002" rpy="0 0 0"/>
    <axis xyz="0 -1 0"/>
    <limit lower="${-joint_limit}" upper="${joint_limit}" effort="${servo_effort}" velocity="${servo_speed}"/>
  </joint>
  <link name="leg3_femur_link">
    <xacro:if value="${use_meshes}">
      <visual><geometry><mesh filename="package://hexapod_description/meshes/leg3_femur_servo.stl"/></geometry><material name="servo"/></visual>
      <visual><geometry><mesh filename="package://hexapod_description/meshes/leg3_femur_print.stl"/></geometry><material name="print"/></visual>
    </xacro:if>
    <xacro:unless value="${use_meshes}">
      <visual><origin xyz="0.04052 0.00123 -0.00016"/><geometry><box size="0.12237 0.04754 0.036"/></geometry><material name="print"/></visual>
    </xacro:unless>
    <collision><origin xyz="0.04052 0.00123 -0.00016"/><geometry><box size="0.12237 0.04754 0.036"/></geometry></collision>
    <inertial><origin xyz="0.04055 0.00151 -0.00016"/><mass value="0.1310"/><inertia ixx="2.689e-05" ixy="3.455e-07" ixz="-6.187e-13" iyy="1.747e-04" iyz="-2.169e-13" izz="1.897e-04"/></inertial>
  </link>
  <joint name="leg3_tibia_joint" type="revolute">
    <parent link="leg3_femur_link"/><child link="leg3_tibia_link"/>
    <origin xyz="0.08012 0 -0.00009" rpy="0 0 0"/>
    <axis xyz="0 1 0"/>
    <limit lower="${-joint_limit}" upper="${joint_limit}" effort="${servo_effort}" velocity="${servo_speed}"/>
  </joint>
  <link name="leg3_tibia_link">
    <xacro:if value="${use_meshes}">
      <visual><geometry><mesh filename="package://hexapod_description/meshes/leg3_tibia_print.stl"/></geometry><material name="print"/></visual>
      <visual><geometry><mesh filename="package://hexapod_description/meshes/leg3_tibia_horn.stl"/></geometry><material name="horn"/></visual>
    </xacro:if>
    <xacro:unless value="${use_meshes}">
      <visual><origin xyz="-0.0064 -0.00099 -0.07333"/><geometry><box size="0.04442 0.05809 0.17653"/></geometry><material name="print"/></visual>
    </xacro:unless>
    <collision><origin xyz="-0.0064 -0.00099 -0.06333"/><geometry><box size="0.04442 0.05809 0.15653"/></geometry></collision>
    <collision name="leg3_foot_collision"><origin xyz="-0.00419 -0.00494 -0.15323"/><geometry><sphere radius="0.008"/></geometry></collision>
    <inertial><origin xyz="0.00007 -0.00014 -0.06349"/><mass value="0.0372"/><inertia ixx="1.189e-04" ixy="-4.593e-07" ixz="1.306e-06" iyy="1.101e-04" iyz="-2.004e-06" izz="1.490e-05"/></inertial>
  </link>
  <link name="leg3_foot"/>
  <joint name="leg3_foot_joint" type="fixed">
    <parent link="leg3_tibia_link"/><child link="leg3_foot"/>
    <origin xyz="-0.00419 -0.00494 -0.16123"/>
  </joint>

  <!-- ============================== LEG 4 ============================== -->

  <joint name="leg4_coxa_joint" type="revolute">
    <parent link="base_link"/><child link="leg4_coxa_link"/>
    <origin xyz="0.00011 0.14751 0" rpy="0 0 1.56533"/>
    <axis xyz="0 0 -1"/>
    <limit lower="${-joint_limit}" upper="${joint_limit}" effort="${servo_effort}" velocity="${servo_speed}"/>
  </joint>
  <link name="leg4_coxa_link">
    <xacro:if value="${use_meshes}">
      <visual><geometry><mesh filename="package://hexapod_description/meshes/leg4_coxa_print.stl"/></geometry><material name="print"/></visual>
      <visual><geometry><mesh filename="package://hexapod_description/meshes/leg4_coxa_horn.stl"/></geometry><material name="horn"/></visual>
    </xacro:if>
    <xacro:unless value="${use_meshes}">
      <visual><origin xyz="0.03439 0.00035 -0.00035"/><geometry><box size="0.12933 0.05828 0.058"/></geometry><material name="print"/></visual>
    </xacro:unless>
    <collision><origin xyz="0.03439 0.00035 -0.00035"/><geometry><box size="0.12933 0.05828 0.058"/></geometry></collision>
    <inertial><origin xyz="0.03479 0.00137 0.00092"/><mass value="0.0266"/><inertia ixx="1.178e-05" ixy="-7.435e-07" ixz="7.271e-07" iyy="3.595e-05" iyz="4.332e-08" izz="3.615e-05"/></inertial>
  </link>
  <joint name="leg4_femur_joint" type="revolute">
    <parent link="leg4_coxa_link"/><child link="leg4_femur_link"/>
    <origin xyz="0.06995 0 -0.0002" rpy="0 0 0"/>
    <axis xyz="0 -1 0"/>
    <limit lower="${-joint_limit}" upper="${joint_limit}" effort="${servo_effort}" velocity="${servo_speed}"/>
  </joint>
  <link name="leg4_femur_link">
    <xacro:if value="${use_meshes}">
      <visual><geometry><mesh filename="package://hexapod_description/meshes/leg4_femur_servo.stl"/></geometry><material name="servo"/></visual>
      <visual><geometry><mesh filename="package://hexapod_description/meshes/leg4_femur_print.stl"/></geometry><material name="print"/></visual>
    </xacro:if>
    <xacro:unless value="${use_meshes}">
      <visual><origin xyz="0.04007 0.0022 -0.00016"/><geometry><box size="0.12237 0.04781 0.036"/></geometry><material name="print"/></visual>
    </xacro:unless>
    <collision><origin xyz="0.04007 0.0022 -0.00016"/><geometry><box size="0.12237 0.04781 0.036"/></geometry></collision>
    <inertial><origin xyz="0.04002 0.00247 -0.00016"/><mass value="0.1310"/><inertia ixx="2.697e-05" ixy="-6.763e-07" ixz="-1.652e-12" iyy="1.747e-04" iyz="-5.198e-14" izz="1.898e-04"/></inertial>
  </link>
  <joint name="leg4_tibia_joint" type="revolute">
    <parent link="leg4_femur_link"/><child link="leg4_tibia_link"/>
    <origin xyz="0.08012 0 -0.00009" rpy="0 0 0"/>
    <axis xyz="0 1 0"/>
    <limit lower="${-joint_limit}" upper="${joint_limit}" effort="${servo_effort}" velocity="${servo_speed}"/>
  </joint>
  <link name="leg4_tibia_link">
    <xacro:if value="${use_meshes}">
      <visual><geometry><mesh filename="package://hexapod_description/meshes/leg4_tibia_print.stl"/></geometry><material name="print"/></visual>
      <visual><geometry><mesh filename="package://hexapod_description/meshes/leg4_tibia_horn.stl"/></geometry><material name="horn"/></visual>
    </xacro:if>
    <xacro:unless value="${use_meshes}">
      <visual><origin xyz="-0.00686 0.00085 -0.07333"/><geometry><box size="0.04434 0.05817 0.17653"/></geometry><material name="print"/></visual>
    </xacro:unless>
    <collision><origin xyz="-0.00686 0.00085 -0.06333"/><geometry><box size="0.04434 0.05817 0.15653"/></geometry></collision>
    <collision name="leg4_foot_collision"><origin xyz="-0.00419 -0.00494 -0.15323"/><geometry><sphere radius="0.008"/></geometry></collision>
    <inertial><origin xyz="-0.0005 0.00167 -0.06349"/><mass value="0.0372"/><inertia ixx="1.190e-04" ixy="-4.463e-07" ixz="1.328e-06" iyy="1.101e-04" iyz="-1.939e-06" izz="1.499e-05"/></inertial>
  </link>
  <link name="leg4_foot"/>
  <joint name="leg4_foot_joint" type="fixed">
    <parent link="leg4_tibia_link"/><child link="leg4_foot"/>
    <origin xyz="-0.00419 -0.00494 -0.16123"/>
  </joint>

  <!-- ============================== LEG 5 ============================== -->

  <joint name="leg5_coxa_joint" type="revolute">
    <parent link="base_link"/><child link="leg5_coxa_link"/>
    <origin xyz="-0.12052 0.10344 0" rpy="0 0 2.30169"/>
    <axis xyz="0 0 -1"/>
    <limit lower="${-joint_limit}" upper="${joint_limit}" effort="${servo_effort}" velocity="${servo_speed}"/>
  </joint>
  <link name="leg5_coxa_link">
    <xacro:if value="${use_meshes}">
      <visual><geometry><mesh filename="package://hexapod_description/meshes/leg5_coxa_print.stl"/></geometry><material name="print"/></visual>
      <visual><geometry><mesh filename="package://hexapod_description/meshes/leg5_coxa_horn.stl"/></geometry><material name="horn"/></visual>
    </xacro:if>
    <xacro:unless value="${use_meshes}">
      <visual><origin xyz="0.03439 0.00011 -0.00035"/><geometry><box size="0.12919 0.05801 0.058"/></geometry><material name="print"/></visual>
    </xacro:unless>
    <collision><origin xyz="0.03439 0.00011 -0.00035"/><geometry><box size="0.12919 0.05801 0.058"/></geometry></collision>
    <inertial><origin xyz="0.03481 0.00125 0.00092"/><mass value="0.0266"/><inertia ixx="1.174e-05" ixy="-6.228e-07" ixz="7.268e-07" iyy="3.595e-05" iyz="3.898e-08" izz="3.611e-05"/></inertial>
  </link>
  <joint name="leg5_femur_joint" type="revolute">
    <parent link="leg5_coxa_link"/><child link="leg5_femur_link"/>
    <origin xyz="0.06995 0 -0.0002" rpy="0 0 0"/>
    <axis xyz="0 -1 0"/>
    <limit lower="${-joint_limit}" upper="${joint_limit}" effort="${servo_effort}" velocity="${servo_speed}"/>
  </joint>
  <link name="leg5_femur_link">
    <xacro:if value="${use_meshes}">
      <visual><geometry><mesh filename="package://hexapod_description/meshes/leg5_femur_servo.stl"/></geometry><material name="servo"/></visual>
      <visual><geometry><mesh filename="package://hexapod_description/meshes/leg5_femur_print.stl"/></geometry><material name="print"/></visual>
    </xacro:if>
    <xacro:unless value="${use_meshes}">
      <visual><origin xyz="0.04003 0.00174 -0.00016"/><geometry><box size="0.12236 0.04726 0.036"/></geometry><material name="print"/></visual>
    </xacro:unless>
    <collision><origin xyz="0.04003 0.00174 -0.00016"/><geometry><box size="0.12236 0.04726 0.036"/></geometry></collision>
    <inertial><origin xyz="0.04003 0.00202 -0.00016"/><mass value="0.1310"/><inertia ixx="2.681e-05" ixy="-1.766e-08" ixz="-1.531e-14" iyy="1.747e-04" iyz="-2.130e-13" izz="1.896e-04"/></inertial>
  </link>
  <joint name="leg5_tibia_joint" type="revolute">
    <parent link="leg5_femur_link"/><child link="leg5_tibia_link"/>
    <origin xyz="0.08012 0 -0.00009" rpy="0 0 0"/>
    <axis xyz="0 1 0"/>
    <limit lower="${-joint_limit}" upper="${joint_limit}" effort="${servo_effort}" velocity="${servo_speed}"/>
  </joint>
  <link name="leg5_tibia_link">
    <xacro:if value="${use_meshes}">
      <visual><geometry><mesh filename="package://hexapod_description/meshes/leg5_tibia_print.stl"/></geometry><material name="print"/></visual>
      <visual><geometry><mesh filename="package://hexapod_description/meshes/leg5_tibia_horn.stl"/></geometry><material name="horn"/></visual>
    </xacro:if>
    <xacro:unless value="${use_meshes}">
      <visual><origin xyz="-0.00694 0.00012 -0.07333"/><geometry><box size="0.04431 0.058 0.17653"/></geometry><material name="print"/></visual>
    </xacro:unless>
    <collision><origin xyz="-0.00694 0.00012 -0.06333"/><geometry><box size="0.04431 0.058 0.15653"/></geometry></collision>
    <collision name="leg5_foot_collision"><origin xyz="-0.00419 -0.00494 -0.15323"/><geometry><sphere radius="0.008"/></geometry></collision>
    <inertial><origin xyz="-0.00045 0.00094 -0.06349"/><mass value="0.0372"/><inertia ixx="1.190e-04" ixy="-4.612e-07" ixz="1.317e-06" iyy="1.100e-04" iyz="-1.935e-06" izz="1.490e-05"/></inertial>
  </link>
  <link name="leg5_foot"/>
  <joint name="leg5_foot_joint" type="fixed">
    <parent link="leg5_tibia_link"/><child link="leg5_foot"/>
    <origin xyz="-0.00419 -0.00494 -0.16123"/>
  </joint>

  <!-- ============================= SENSORS ============================= -->

  <!-- RPLIDAR C1, frame on the (approximate) scan plane -->
  <link name="laser"/>
  <joint name="laser_joint" type="fixed">
    <parent link="base_link"/><child link="laser"/>
    <origin xyz="-0.00448 -0.00012 0.06458" rpy="0 0 $(arg laser_yaw)"/>
  </joint>

  <!-- ESP-EYE camera on the front, looking forward -->
  <link name="camera_link"/>
  <joint name="camera_joint" type="fixed">
    <parent link="base_link"/><child link="camera_link"/>
    <origin xyz="0.0997 0.00414 0.03431"/>
  </joint>
  <link name="camera_optical_frame"/>
  <joint name="camera_optical_joint" type="fixed">
    <parent link="camera_link"/><child link="camera_optical_frame"/>
    <origin rpy="${-pi/2} 0 ${-pi/2}"/>
  </joint>

  <!-- MPU6050: NOT IN THE CAD - move this to where the board really is -->
  <link name="imu_link">
    <visual><geometry><box size="0.021 0.016 0.003"/></geometry><material name="board"/></visual>
  </link>
  <joint name="imu_joint" type="fixed">
    <parent link="base_link"/><child link="imu_link"/>
    <origin xyz="0 0 -0.0237"/>
  </joint>

  <!-- ============================= GRIPPER ============================= -->
  <!-- SG90 gripper: NOT IN THE CAD - simple placeholder at the BACK, jaws pointing backward -->
  <xacro:property name="jaw_travel" value="${radians(50)/2}"/>

  <link name="gripper_base">
    <visual><geometry><box size="0.023 0.033 0.012"/></geometry><material name="servo"/></visual>
    <collision><geometry><box size="0.023 0.033 0.012"/></geometry></collision>
  </link>
  <joint name="gripper_mount" type="fixed">
    <parent link="base_link"/><child link="gripper_base"/>
    <origin xyz="-0.1559 0 -0.0137" rpy="0 0 ${pi}"/>
  </joint>

  <xacro:macro name="jaw" params="name">
    <link name="${name}">
      <visual><origin xyz="0.020 0 0"/><geometry><box size="0.040 0.004 0.012"/></geometry><material name="print"/></visual>
      <collision><origin xyz="0.020 0 0"/><geometry><box size="0.040 0.004 0.012"/></geometry></collision>
      <inertial><origin xyz="0.020 0 0"/><mass value="0.005"/>
        <inertia ixx="1e-7" ixy="0" ixz="0" iyy="7e-7" iyz="0" izz="7e-7"/></inertial>
    </link>
  </xacro:macro>
  <xacro:jaw name="gripper_left_jaw"/>
  <xacro:jaw name="gripper_right_jaw"/>

  <joint name="gripper_joint" type="revolute">
    <parent link="gripper_base"/><child link="gripper_left_jaw"/>
    <origin xyz="0.012 0.012 0" rpy="0 0 ${jaw_travel}"/>
    <axis xyz="0 0 -1"/>
    <limit lower="0" upper="${jaw_travel}" effort="0.18" velocity="5.0"/>
  </joint>
  <joint name="gripper_right_joint" type="revolute">
    <parent link="gripper_base"/><child link="gripper_right_jaw"/>
    <origin xyz="0.012 -0.012 0" rpy="0 0 ${-jaw_travel}"/>
    <axis xyz="0 0 1"/>
    <limit lower="0" upper="${jaw_travel}" effort="0.18" velocity="5.0"/>
    <mimic joint="gripper_joint" multiplier="1" offset="0"/>
  </joint>

</robot>
