codekorarjonno/18-DOF-Hexapod/raspberry_pi/ros2_ws/src/hexapod_mapping/config/mapper_params.yaml

slam_toolbox:
  ros__parameters:
    use_sim_time: false

    solver_plugin: solver_plugins::CeresSolver
    ceres_linear_solver: SPARSE_NORMAL_CHOLESKY
    ceres_preconditioner: SCHUR_JACOBI
    ceres_trust_strategy: LEVENBERG_MARQUARDT

    odom_frame: odom
    map_frame: map
    base_frame: base_link
    scan_topic: /scan
    mode: mapping

    debug_logging: true
    throttle_scans: 1
    transform_publish_period: 0.02
    map_update_interval: 1.0
    resolution: 0.05
    max_laser_range: 12.0
    minimum_time_interval: 0.5
    transform_timeout: 0.5
    tf_buffer_duration: 30.0
    stack_size_to_use: 40000000

    use_scan_matching: true
    use_scan_barycenter: true
    minimum_travel_distance: 0.2
    minimum_travel_heading: 0.2
    scan_buffer_size: 20
    scan_buffer_maximum_scan_distance: 12.0
    link_match_minimum_response_fine: 0.1
    link_scan_maximum_distance: 2.0
    loop_search_maximum_distance: 4.0
    do_loop_closing: true
