codekorarjonno/18-DOF-Hexapod/(commit log)

2026-10-17 Initial upload: hexapod assembly
2026-11-02 Add ROS 2 workspace, ESP32 firmware v2, maps and shortcuts
2026-11-02 Move CAD into solidworks/, add demo video, ROS 2 workspace, firmware, maps
2026-11-06 Add Raspberry Pi files: ROS 2 packages, map, shortcuts, camera script, third-party list
